dsun7c4/kicad-lib/README.md

# kicad-lib

Library of parts used in the kicad design repositories.
Some are modified versions of the standard kicad library and others
are newly created.  The earlier models and footprints were done with
kicad 4.x and freecad 0.15.
