dsun7c4/kicad-lib/(commit log)

2020-04-01 Add kicad local libraries
2020-04-01 Turn off some 3D models Check in gerber files Ordered...
2020-04-01 Checkpoint DCDC converter evaluation board.
2020-04-01 Fix up thermal via footprint to work with OSHPark.
2020-04-01 Fix pad position for inductor (1mm too wide). Regenerate gerbers. Upload to OSHPark.
2020-04-01 Add connector for microzed board.
2020-04-01 Add mounting hole using NPTH pad type.
2020-04-01 Add footprint for Lumex 7-segment display. Add footprint for LED current driver chip, SOIC-24.
2020-04-01 Minor local library footprint cleanup.
2020-04-01 Clean up 7-segment footprint drawing.
2020-04-01 Correct segment vertex point calculations. Regenerate footprint.
2020-04-01 Add 7-segment schematic symbol and TLC59282 driver chip.
2020-04-01 Fix pin type for TLC59282 pin 18 (OUT13). Set scale to 0.5 for 3d model of 25mil pitch SOIC24.
2020-04-01 Adjust the pin drill size for the 7-seg display.
2020-04-01 Add pin header with edge connect footprint.
2020-04-01 Adjust the silk screen a little. Move some vias out of back silkscreen. Stitch in some more ground fill. Upload to OSHPark.
2020-04-01 Checkpoint schematic symbol for 2x50 connector.
2020-04-01 Remove silk from through hole pads.
2020-04-01 Add Ad5662, ADT7410, DS3231, LTC2990, NE5532, Resistor, and cx210 schematic symbols.
2020-04-01 Add GPS receiver, VCXO, LP3853, MIC5225 and PCA9306 schematic symbols.
2020-04-01 Add footprint for CX210 and adafruit GPS module. Add DAC8830 and LVM722. Increase hole size for LDD-A814RI.
2020-04-01 Add footprint for VCXO, GTop GPS module.
2020-04-01 Add power symbols.
2020-04-01 Add more BOM parameters to local parts.
2020-04-01 Add current sense resistors.
2020-04-01 Add heatsink and RF coax connector footprint.
2020-04-01 Add schematic symbol for TO-220 heatsink. Add TO-220 footprint. Add Microzed mechanical footprint.
2020-04-01 Add some markers in the Microzed mechanical footprint. Add single gate buffer.
2020-04-01 Add PWM fan connector.
2020-04-01 Add footprint for Maxim RTC.
2020-04-01 Add SOT-23-5 footprint. Add more detail to microzed mechanical footprint.
2020-04-01 Add OCXO cover mechanical footprint. Add CR2032 battery holder.
2020-04-01 Add On semi SOD-323 footprint. Add keepout comments to CX210 cover and adafruit 746 footprints.
2020-04-01 Rename CUS520 footprint.
2020-04-01 Add stitching via footprint.
2020-04-01 Add NXP SOT-23 recommended footprint.
2020-04-01 Add 16 pin 8x2 header connector.
2020-04-01 Set value to be invisible. Add large stitching via / heatsink vent hole.
2020-04-01 Add breakout footprint for FVXO to CX210. Add connector symbol to tie mounting holes to ground.
2020-04-01 Fix pad location for to-220-5. Increase hole size slightly for heatsink. Add 3D models.
2020-04-01 3D models for to220-5, cx210, heatsink.
2020-04-01 Add 3d model of PWM fan connector.
2020-04-01 Chamfer the pin holes.
2020-04-01 Add 3D model for 100 pin FCI connector, Phoenix terminal block and RF connector.
2020-04-01 Current shunt 3D model.
2020-04-01 Turn off silk on through hole pins.
2020-04-01 Turn off silk on through hole pads.
2020-04-01 Footprints for connector and termination board.
2020-04-01 3D models for battery holder and ribbon cable connector. Adjust drill size slightly.
2020-04-01 Add 3D model for tactile switch and connector.
2020-04-01 Update 3d models for connectors.
2020-04-01 3D model for GPS receiver. Adjust annular ring for XG4 connectors.
2020-04-01 Add a hand soldering footprint for the SOD-323 package. Adjust the hand soldering footprint for the SOT-23 package.
2020-04-01 Clean up DRC warnings and errors. Connect the RTC 32KHz clock to a FPGA clock pin.
2020-04-01 Change size of edge fingers for board to board connection.
2020-04-01 Smaller pad for hand soldering 0805 and 1206 packages.
2020-04-01 Update 3D model for 7-segment LED display.
2020-04-01 Make pad 0.2mm larger for hand soldering 0805 capacitor.
2020-04-01 Hand soldering version of SOT-23-5. Pads 0.2mm longer.
2020-04-01 Add 3D model for the cx210 cover. Add silk outline for the 1x9 connector on Adafruit's GPS module.
2020-04-01 Add 3D model for SOD-323 diode.
2020-04-01 0805 LED hand soldering footprint. Red and green 3D model for LED.
2020-04-01 Adjust courtyard for diode footprint.
2020-04-01 Add a VAA power symbol.
2020-04-01 Footprint and 3D model of panel mount rj45, usb-a and usb-b connectors.
2020-04-01 Adjust pad size to increase clearances. Add a PTC symbol to the schematic library.
2020-04-01 Footprints for connecting a wire.
2020-04-01 Use 4.0.7 library for local footprint 3D models. Copy rescued symbols into local library.
2020-04-01 1206 Resistor hand soldering footprint.
2020-04-01 Step models for the local footprints.
2020-04-01 Change pin 1 pad to a square.
2020-04-01 Make the three holes large enough for a 22Ga wire. Add SIM connector and i2c eeprom to the library.
2020-04-01 Checkpoint parallel port i2c design.
2020-04-01 Add footprint for inductor, diode, and DFN package.
2020-04-01 Start new display board 8x 16-segment LED display.
2020-04-01 3D model for 16seg Kingbright PSA08-11SRWA LED display.
2020-04-01 Update 3D model path of local modules for kicad 5.x.
2020-04-01 Center the 4-pin DC-DC converter SIP package on pin 1.
2020-04-01 New footprints and 3D models: LED, Binding Post, Heatsink.
2020-04-01 Add switch footprint. Fix up some of the courtyard regions.
2020-04-01 Fill in the footprint descriptions.
2020-04-01 Add horizontal mount SPDT switch. Increase the size of the stitching holes for the binding post.
2020-04-01 Add a current source chip to the library. Add F.Fab layer drawing to footprints.
2020-04-01 Center through hole switches on pin 1. Add f.Fab layer drawing to LED.
2020-04-01 Fill in the cathode line on the LED silkscreen.
2020-04-01 Change pin number preference on the PSSI2021SAY symbol.
2020-04-01 Battery holder and ribbon cable connector.
2020-04-01 Tactile switch and connector model.
2020-04-01 Add more detail to battery holder. Add locking levers. Add 1x9 female header.
2020-04-01 Fix corner relief cut in sketch.
2020-04-01 Another display rail design. Simple version for cx210 cover design.
2020-04-01 3D model of SOD-323 diode.
2020-04-01 0805 LED model.
2020-04-01 Model of panel mount rj45, usb-a and usb-b connectors.
2020-04-01 3D model of Molex SIM connector 475500001.
2020-04-01 3D model for Kingbright PSA08-11SRWA 16seg LED display.
2020-04-01 Binding post and heat sink model.
2020-04-01 Separate gold plated inserts into a different body.
2020-04-01 Fix hole size on the 7016 spacer. Set appearance parameters for Ohmite heat sink.
2020-04-05 Add symbol and footprint for TOTX1350(F) TOSLINK transmitter.
2020-05-07 freecad parametric 3D model for the TE Connectivity 2mm pitch HPI connector.
2020-05-07 Add TE Connectivity 2mm pitch HPI connector footprint and 3D model.
2020-05-13 Add 3D model to the TOTX1350F footprint.
2021-06-18 Add Fab layer and adjust CrtYd layer. Add 12 pin PMOD header for Avnet Microzed IO card.
2021-06-24 Add Molex 3-pin connector series 6373 (PC fan).
2021-09-30 Update Fab and CrtYd layers for battery holder, coax connector, and GPS module.
2021-09-30 Clean up Fab layer for OCXO footprint.
2021-10-18 Change pin one to rounded rectangle on TOTX1350F. Move pin marker silk slightly on 1x7 header.
2021-11-12 Add symbol and footprint for the CX205 series OCXO. Add 4-bit DIP switch footprint. Rename header footprint to identify the Pmod pinout.
2021-11-12 Clean up names and descriptions for the new DIP switch and connector parts.
2021-11-19 Change the attribute of the CSM2512 footprint to surface mount. Add 3D model to the CX205 footprint.
2021-11-19 Add step and wrl models for the cx205 footprint.
2021-12-19 Add fab layer to the SOIC-16-Maxim footprint. Copy SOT-323 footprint and adjust the hand soldering pad size.
2021-12-25 Add model for right angle SMA connector. Clean up some of the dependencies in the cx205 and TOTX1350 models.
2021-12-25 Add 3D model for TE Connectivity SMA right angle connector.
2024-04-07 Update local symbol library to kicad 8 format.
2024-04-17 Redraw LDD-A814RI for FreeCAD 0.21. Assign material properties to prep for KiCadStepUp export.
2024-04-17 Update LDD-A814RI for KiCad 8 and FreeCAD 0.21 3D model.
2024-04-19 Redraw to220-5 and 581002-heatsink for FreeCAD 0.21. Assign material properties to prep for KiCadStepUp export.
2024-04-19 Fix alignment of pin holes in 581002-heatsink body.
2024-04-19 Update parts for KiCad 8 and FreeCAD 0.21 3D model. [Heatsink_581x, PSA08-11SRWA, TO220-5-Vertical_NDH] Make display segments in symbols polyline instead of single lines.
2024-04-23 Clean up the HPI connector pin body and set appearance to the KiCad material reference.
2024-04-24 Update 440054 connector for KiCad 8 and regenerate 3D model with KiCadSetpUp.
2024-04-25 Update footprint and 3D models for TOTX1350F.
2024-04-26 Update bk-5058 coin cell holder for KiCad 8 and regenerate 3D model with KiCadSetpUp.
2024-11-19 Redraw sim connector in FreeCAD 0.21.
2024-11-19 Regenerate sim connector with KicadStepUp.
2024-11-19 Fix step file rendering of the pin dome for the sim connector.
2024-11-19 Manually regenerate the step file for the sim connector to fix appearance.
2024-11-19 Redraw 61083 Bergstak connector in FreeCAD 0.21.
2024-11-19 Update 61083 Bergstak connector for KiCad 8 and regenerate 3D model with KiCadSetpUp.
2024-11-27 Redraw 7914J key switch in FreeCAD 0.21.
2024-11-27 Update 7914J key switch for KiCad 8 and regenerate 3D model with KiCadSetpUp.
2024-11-27 Redraw 47053 4 pin header housing in FreeCAD 0.21.
2024-11-27 Update 47053 4 pin header housing for KiCad 8 and regenerate 3D model with KiCadSetpUp. Change orientation to KiCad library conventions.
2024-11-27 Add fab layer drawing for 47550 and 61083 connectors
2024-11-27 Change orientation of 61083 and 47550 connectors to KiCad library conventions.
2024-11-27 Change orientation of 61083 and 47550 connectors to KiCad library conventions. Update pin numbering on 47550 connectors to match SIM spec.
2024-12-02 Redraw Vishay CSM foil resistor in FreeCAD 1.0.
2024-12-02 Update Vishay CSM foil resistor for KiCad 8 and regenerate 3D model with KiCadSetpUp.
